ZioGuido/GMLAB_D9X/D9X.jpg

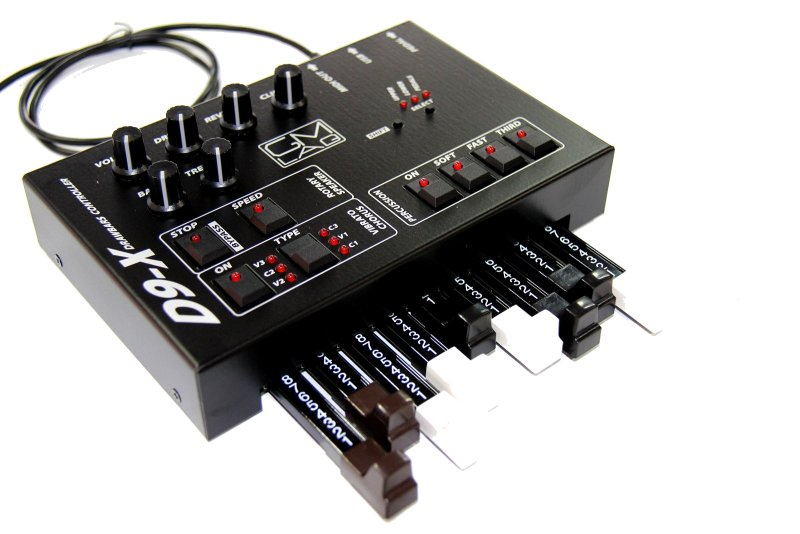
D9X.jpg
