ZioGuido/GMLAB_D9X/README.md

# GMLAB_D9X
Repository for the GMLAB D9X Midi Drawbar Controller

This repository contains the full sources of the GMLAB D9X Midi Drawbar Controller.
Please refer to the included PDF document for details about the project.

Project home page:
http://www.gmlab.it/
