ZioGuido/GMLAB_D9X/PCB/MainBoard.png

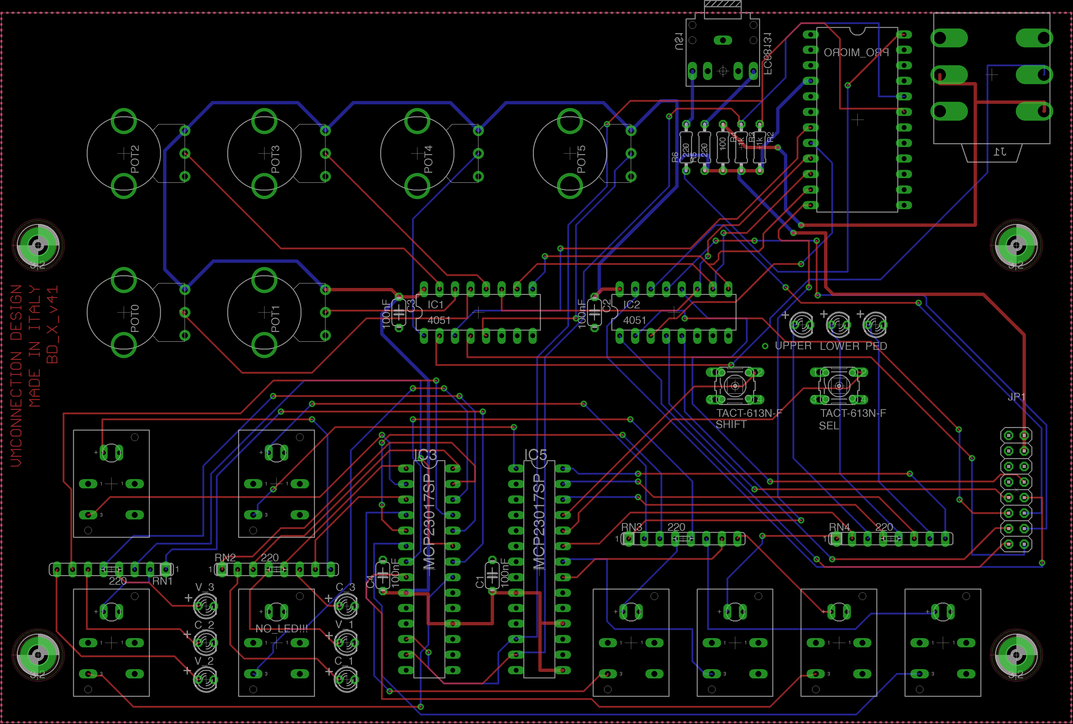
PCB/MainBoard.png
