ZioGuido/GMLAB_D9X/3D/D9X_metal_top.STEP

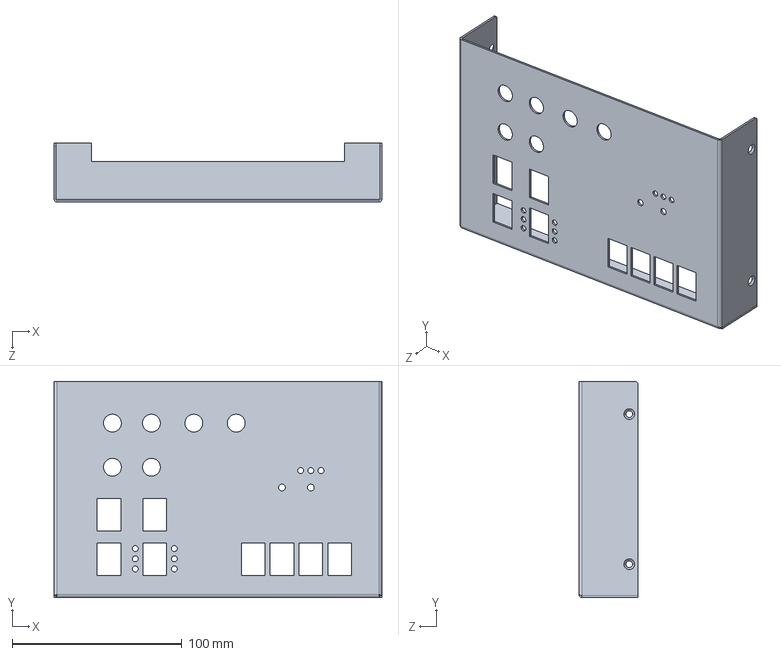
[picture p3: CAD file, 2019-03-20]
3D/D9X_metal_top.STEP
193.4 x 127.5 x 34.9 mm
