ZioGuido/GMLAB_D9X/3D/D9X_metal_base.STEP

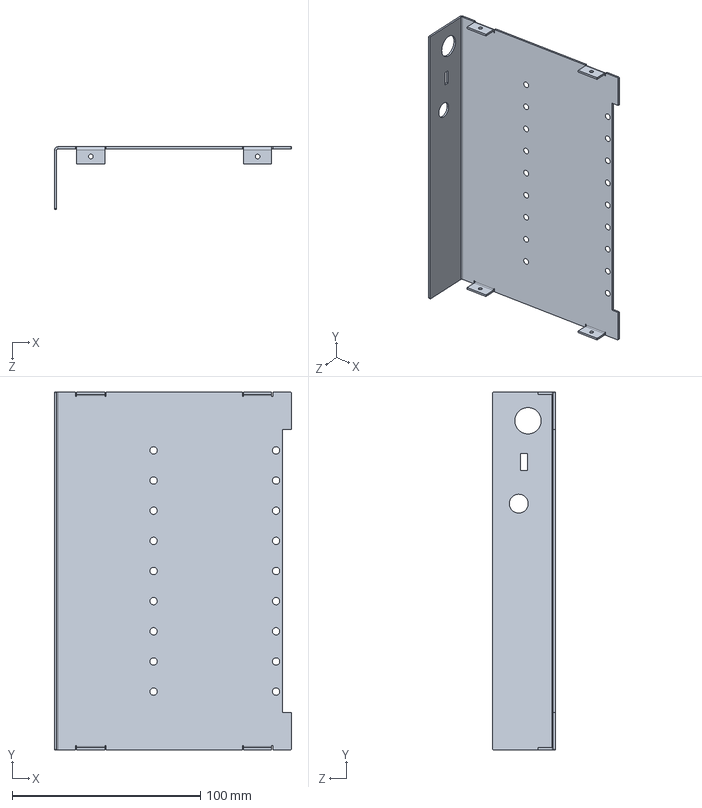
[picture p4: CAD file, 2019-03-20]
3D/D9X_metal_base.STEP
125.8 x 190.0 x 33.2 mm
