ZioGuido/GMLAB_D9X/Silkscreen/D9X.pdf

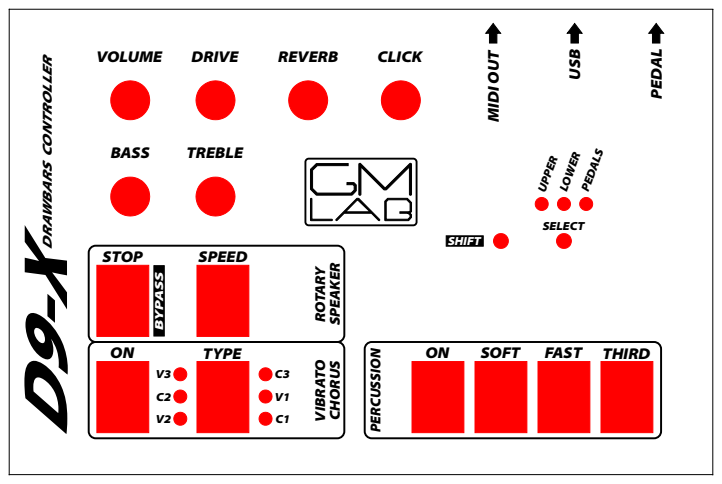
[picture p5: page 1]
SOFT; FAST; THIRD; PERCUSSION; UPPER; LOWER; PEDALS; BASS; TREBLE; VOLUME; DRIVE; REVERB; CLICK; MIDI OUT; USB; PEDAL; D9-XDRAWBARS CONTROLLER; SHIFT; YPASS; SELECT; TYPE; STOP; SPEED; TAR; SPEAKER; VIBR; CHORUS
