ZioGuido/GMLAB_D9X/Eagle/drawbars_v12_2019.brd

## EAGLE design Eagle/drawbars_v12_2019.brd (2019-03-20)

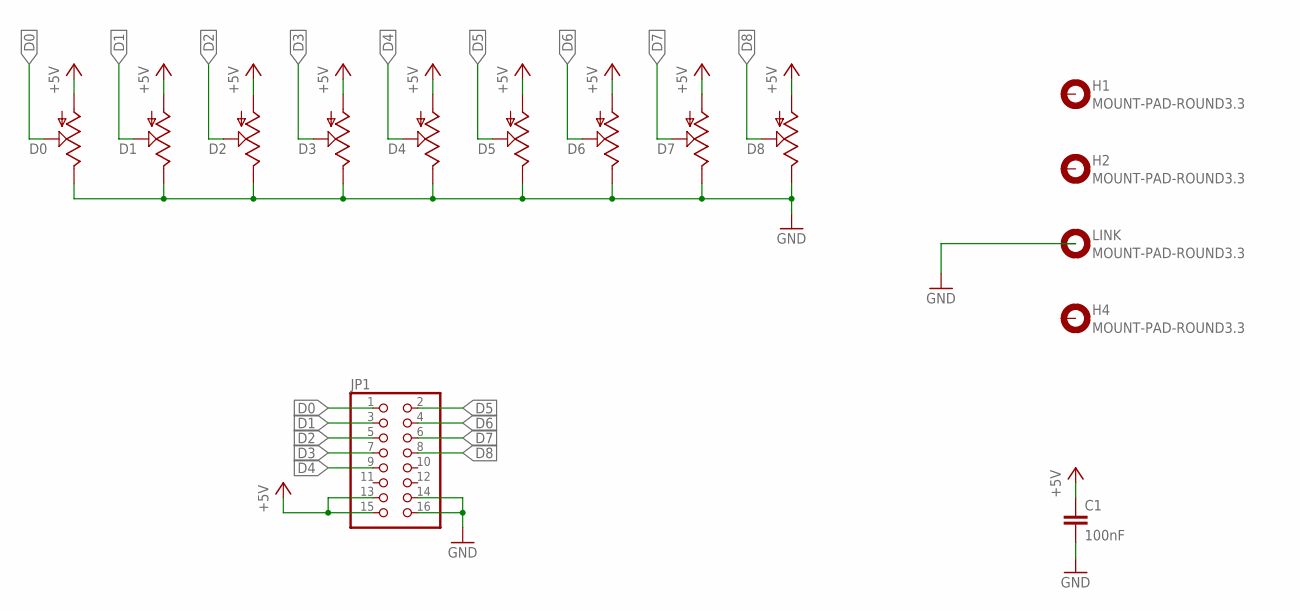
[picture p6: schematic drawbars_v12_2019.sch]

Parts:
C1: 100nF; C050-024X044
D0, D1, D2, D3, D4, D5, D6, D7, D8: POTENTIOMETER; ALPHA_DRAWBARS
H1, H2, H4: MOUNT-PAD-ROUND3.3; 3,3-PAD
JP1: PINHD-2X8; 2X08
LINK: MOUNT-PAD-ROUND3.3; 3,3-PAD

Connections:
+5V: C1.1, D0.P$2 (1), D1.P$2 (1), D2.P$2 (1), D3.P$2 (1), D4.P$2 (1), D5.P$2 (1), D6.P$2 (1), D7.P$2 (1), D8.P$2 (1), JP1.13, JP1.15
D0: D0.P$3 (2), JP1.1
D1: D1.P$3 (2), JP1.3
D2: D2.P$3 (2), JP1.5
D3: D3.P$3 (2), JP1.7
D4: D4.P$3 (2), JP1.9
D5: D5.P$3 (2), JP1.2
D6: D6.P$3 (2), JP1.4
D7: D7.P$3 (2), JP1.6
D8: D8.P$3 (2), JP1.8
GND: C1.2, D0.P$1 (3), D1.P$1 (3), D2.P$1 (3), D3.P$1 (3), D4.P$1 (3), D5.P$1 (3), D6.P$1 (3), D7.P$1 (3), D8.P$1 (3), JP1.14, JP1.16

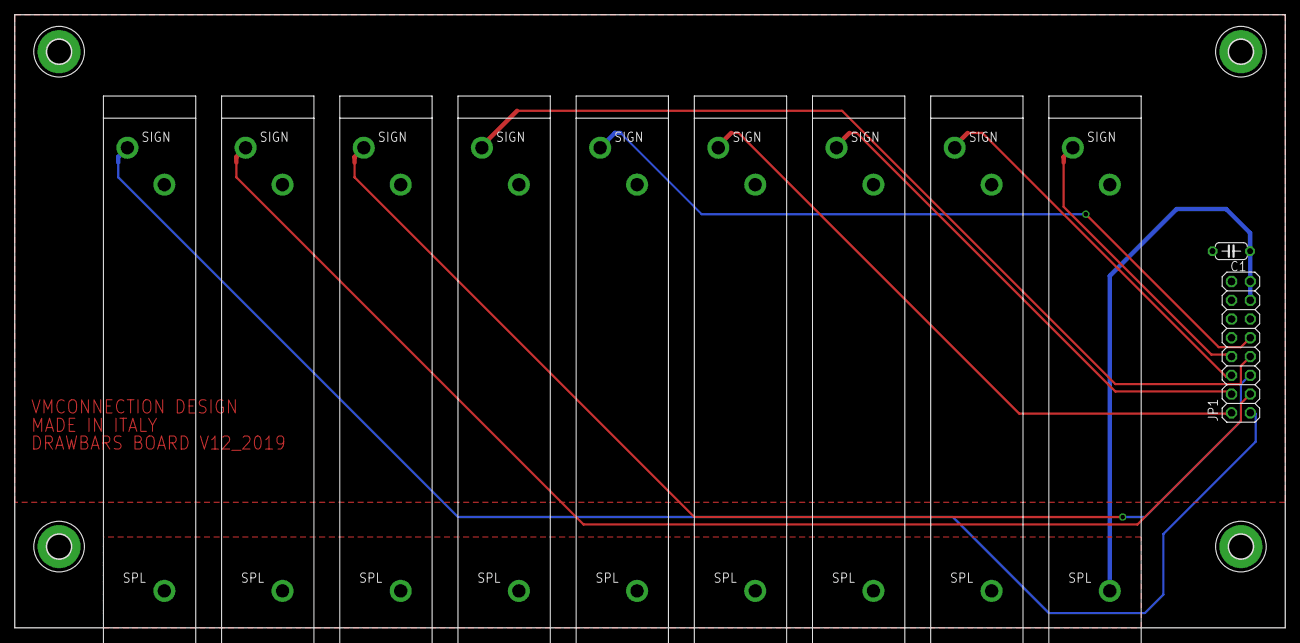
[picture p7: board drawbars_v12_2019.brd from above]

Board: 2 copper layers, 172.0 x 83.0 mm, 15 parts (0 on the bottom side), 11 nets.
