ZioGuido/GMLAB_D9X/Eagle/D9X_v41.brd

## EAGLE design Eagle/D9X_v41.brd (2019-03-20)

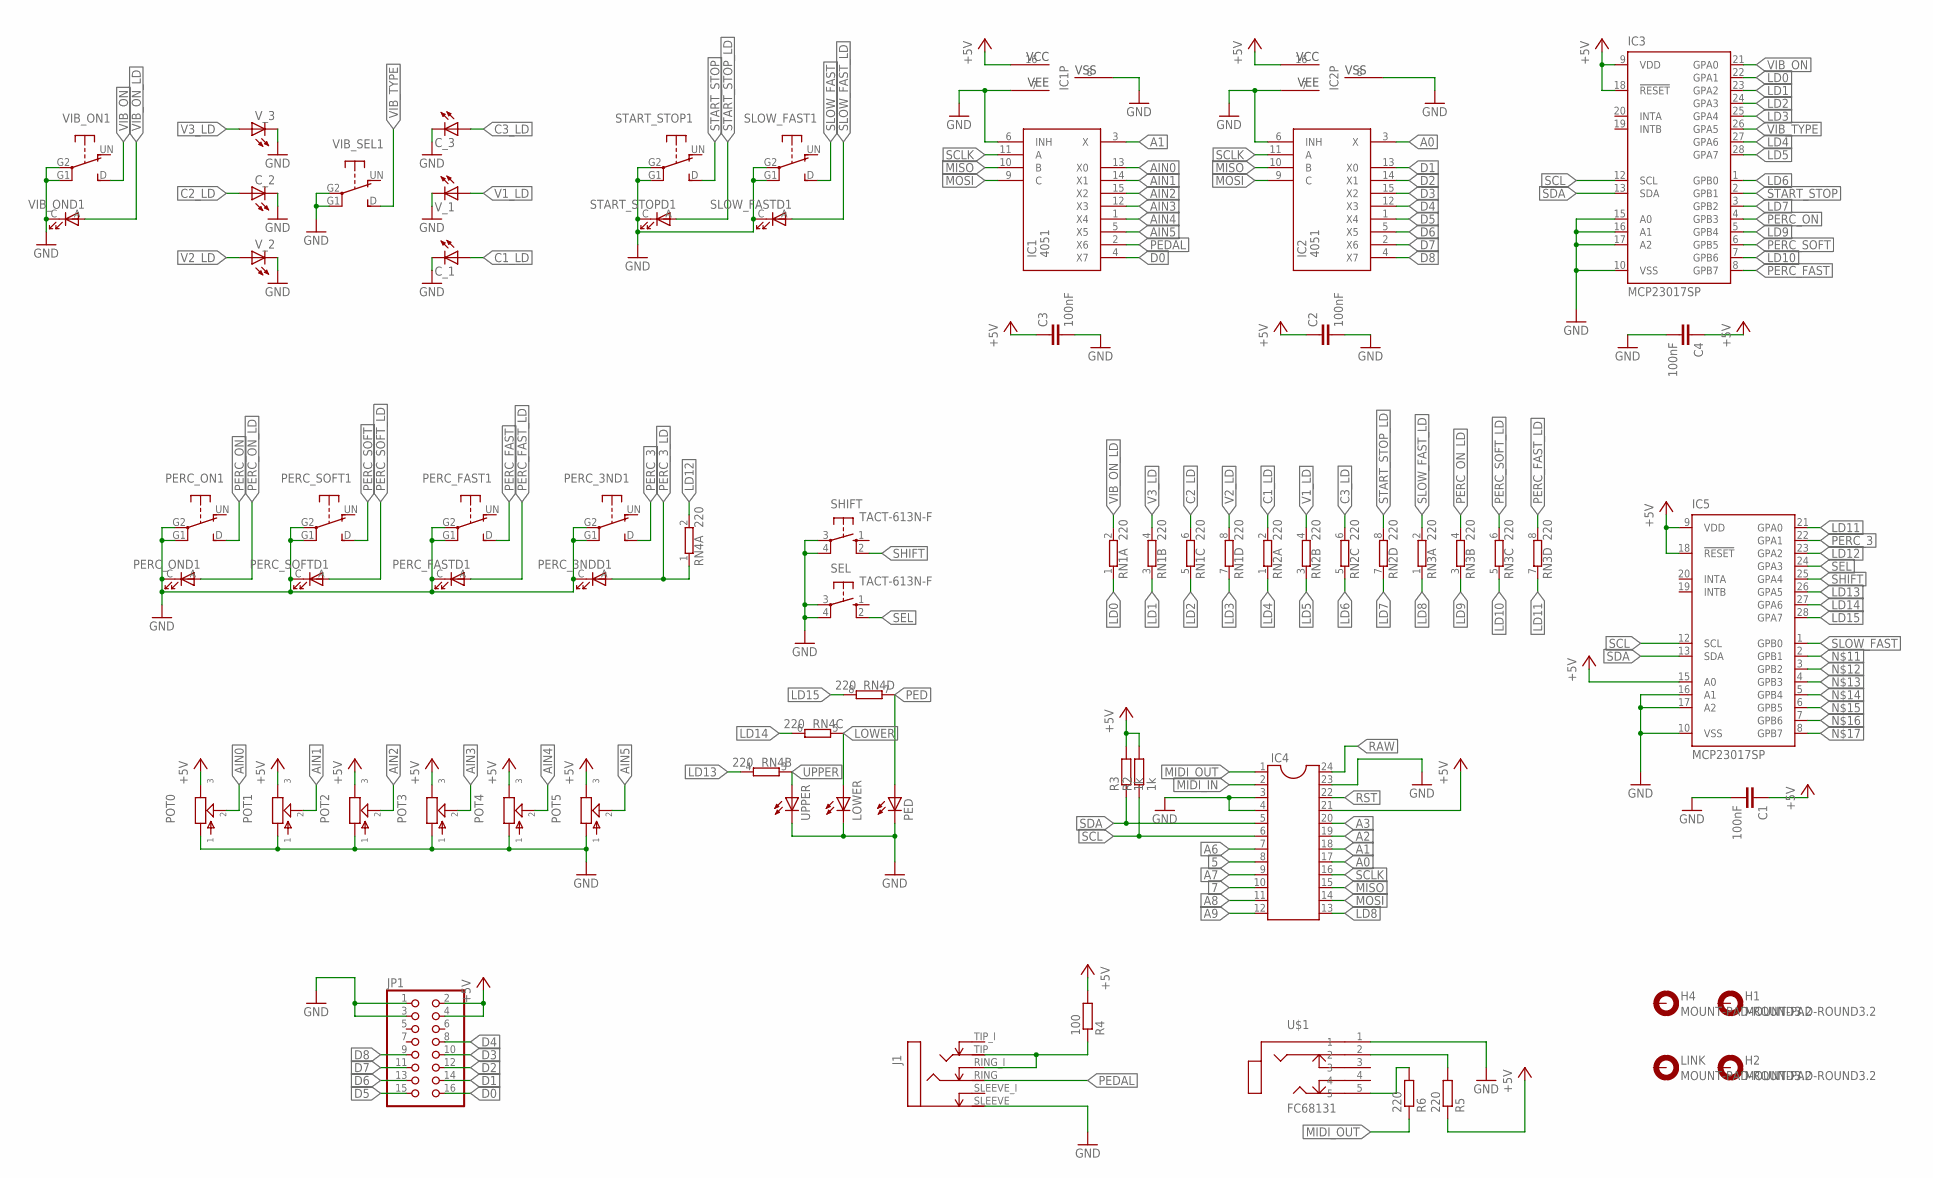
[picture p8: schematic D9X_v41.sch]

Parts:
C1, C2, C3, C4: 100nF; C050-024X044
C_1, C_2, C_3: LED3MM
H1, H2, H4: MOUNT-PAD-ROUND3.2; 3,2-PAD
IC1, IC2: 4051; DIL16
IC3, IC5: MCP23017SP; DIL28-3
IC4: DIL24-6
J1: STEREOSWJACK_ST_TRS_INT; ST_JACK_TRS_INT
JP1: PINHD-2X8; 2X08
LINK: MOUNT-PAD-ROUND3.2; 3,2-PAD
LOWER: LED3MM
PED: LED3MM
PERC_3ND: SRKLSHANPU; SP86N-A1-5-01
PERC_FAST: SRKLSHANPU; SP86N-A1-5-01
PERC_ON: SRKLSHANPU; SP86N-A1-5-01
PERC_SOFT: SRKLSHANPU; SP86N-A1-5-01
POT0, POT1, POT2, POT3, POT4, POT5: POT-EU12MM; RV120DF-40B1-(L)K
R2, R3: 1k; 0204/7
R4: 100; 0204/7
R5, R6: 220; 0204/7
RN1, RN2, RN3, RN4: 220; SIL8
SEL: TACT-613N-F; B3F-10XX
SHIFT: TACT-613N-F; B3F-10XX
SLOW_FAST: SRKLSHANPU; SP86N-A1-5-01
START_STOP: SRKLSHANPU; SP86N-A1-5-01
U$1: FC68131; FC68131-5P
UPPER: LED3MM
VIB_ON: SRKLSHANPU; SP86N-A1-5-01
VIB_SEL: SRKLSHANPU; SP86N-A1-5-01
V_1, V_2, V_3: LED3MM

Connections:
5: IC4.8
7: IC4.10
+5V: C1.1, C2.1, C3.1, C4.1, IC1.16 (VCC), IC2.16 (VCC), IC3.9 (VDD), IC3.18 (!RESET), IC4.21, IC5.9 (VDD), IC5.15 (A0), IC5.18 (!RESET), JP1.2, JP1.4, POT0.3, POT1.3, POT2.3, POT3.3, POT4.3, POT5.3, R2.2, R3.2, R4.2, R5.1
A0: IC2.3 (X), IC4.17
A1: IC1.3 (X), IC4.18
A2: IC4.19
A3: IC4.20
A6: IC4.7
A7: IC4.9
A8: IC4.11
A9: IC4.12
AIN0: IC1.13 (X0), POT0.2
AIN1: IC1.14 (X1), POT1.2
AIN2: IC1.15 (X2), POT2.2
AIN3: IC1.12 (X3), POT3.2
AIN4: IC1.1 (X4), POT4.2
AIN5: IC1.5 (X5), POT5.2
C1_LD: C_1.A, RN2.2
C2_LD: C_2.A, RN1.6 (2)
C3_LD: C_3.A, RN2.6 (2)
D0: IC1.4 (X7), JP1.16
D1: IC2.13 (X0), JP1.14
D2: IC2.14 (X1), JP1.12
D3: IC2.15 (X2), JP1.10
D4: IC2.12 (X3), JP1.8
D5: IC2.1 (X4), JP1.15
D6: IC2.5 (X5), JP1.13
D7: IC2.2 (X6), JP1.11
D8: IC2.4 (X7), JP1.9
GND: C1.2, C2.2, C3.2, C4.2, C_1.K (C), C_2.K (C), C_3.K (C), IC1.6 (INH), IC1.7 (VEE), IC1.8 (VSS), IC2.6 (INH), IC2.7 (VEE), IC2.8 (VSS), IC3.10 (VSS), IC3.15 (A0), IC3.16 (A1), IC3.17 (A2), IC4.3, IC4.4, IC4.23, IC5.10 (VSS), IC5.16 (A1), IC5.17 (A2), J1.SLEEVE (S), JP1.1, JP1.3, LOWER.K (C), PED.K (C), PERC_3ND.C, PERC_3ND.G1, PERC_3ND.G2, PERC_FAST.C, PERC_FAST.G1, PERC_FAST.G2, PERC_ON.C, PERC_ON.G1, PERC_ON.G2, PERC_SOFT.C, PERC_SOFT.G1, PERC_SOFT.G2, POT0.1, POT1.1, POT2.1, POT3.1, POT4.1, POT5.1, SEL.3, SEL.4 (P1), SHIFT.3, SHIFT.4 (P1), SLOW_FAST.C, SLOW_FAST.G1, SLOW_FAST.G2, START_STOP.C, START_STOP.G1, START_STOP.G2, U$1.1, UPPER.K (C), VIB_ON.C, VIB_ON.G1, VIB_ON.G2, VIB_SEL.G1, VIB_SEL.G2, V_1.K (C), V_2.K (C), V_3.K (C)
LD0: IC3.22 (GPA1), RN1.1
LD1: IC3.23 (GPA2), RN1.3 (1)
LD2: IC3.24 (GPA3), RN1.5 (1)
LD3: IC3.25 (GPA4), RN1.7 (1)
LD4: IC3.27 (GPA6), RN2.1
LD5: IC3.28 (GPA7), RN2.3 (1)
LD6: IC3.1 (GPB0), RN2.5 (1)
LD7: IC3.3 (GPB2), RN2.7 (1)
LD8: IC4.13, RN3.1
LD9: IC3.5 (GPB4), RN3.3 (1)
LD10: IC3.7 (GPB6), RN3.5 (1)
LD11: IC5.21 (GPA0), RN3.7 (1)
LD12: IC5.23 (GPA2), RN4.2
LD13: IC5.26 (GPA5), RN4.4 (2)
LD14: IC5.27 (GPA6), RN4.6 (2)
LD15: IC5.28 (GPA7), RN4.8 (2)
LOWER: LOWER.A, RN4.5 (1)
MIDI_IN: IC4.2
MIDI_OUT: IC4.1, R6.1
MISO: IC1.10 (B), IC2.10 (B), IC4.15
MOSI: IC1.9 (C), IC2.9 (C), IC4.14
unnamed: J1.RING_I (RN), J1.TIP (T), R4.1
unnamed: R5.2, U$1.2
unnamed: R6.2, U$1.5
PED: PED.A, RN4.7 (1)
PEDAL: IC1.2 (X6), J1.RING (R)
PERC_3: IC5.22 (GPA1), PERC_3ND.D (S)
PERC_3_LD: PERC_3ND.A, RN4.1
PERC_FAST: IC3.8 (GPB7), PERC_FAST.D (S)
PERC_FAST_LD: PERC_FAST.A, RN3.8 (2)
PERC_ON: IC3.4 (GPB3), PERC_ON.D (S)
PERC_ON_LD: PERC_ON.A, RN3.4 (2)
PERC_SOFT: IC3.6 (GPB5), PERC_SOFT.D (S)
PERC_SOFT_LD: PERC_SOFT.A, RN3.6 (2)
RAW: IC4.24
RST: IC4.22
SCL: IC3.12 (SCL), IC4.6, IC5.12 (SCL), R2.1
SCLK: IC1.11 (A), IC2.11 (A), IC4.16
SDA: IC3.13 (SDA), IC4.5, IC5.13 (SDA), R3.1
SEL: IC5.24 (GPA3), SEL.2 (S1)
SHIFT: IC5.25 (GPA4), SHIFT.2 (S1)
SLOW_FAST: IC5.1 (GPB0), SLOW_FAST.D (S)
SLOW_FAST_LD: RN3.2, SLOW_FAST.A
START_STOP: IC3.2 (GPB1), START_STOP.D (S)
START_STOP_LD: RN2.8 (2), START_STOP.A
UPPER: RN4.3 (1), UPPER.A
V1_LD: RN2.4 (2), V_1.A
V2_LD: RN1.8 (2), V_2.A
V3_LD: RN1.4 (2), V_3.A
VIB_ON: IC3.21 (GPA0), VIB_ON.D (S)
VIB_ON_LD: RN1.2, VIB_ON.A
VIB_TYPE: IC3.26 (GPA5), VIB_SEL.D (S)

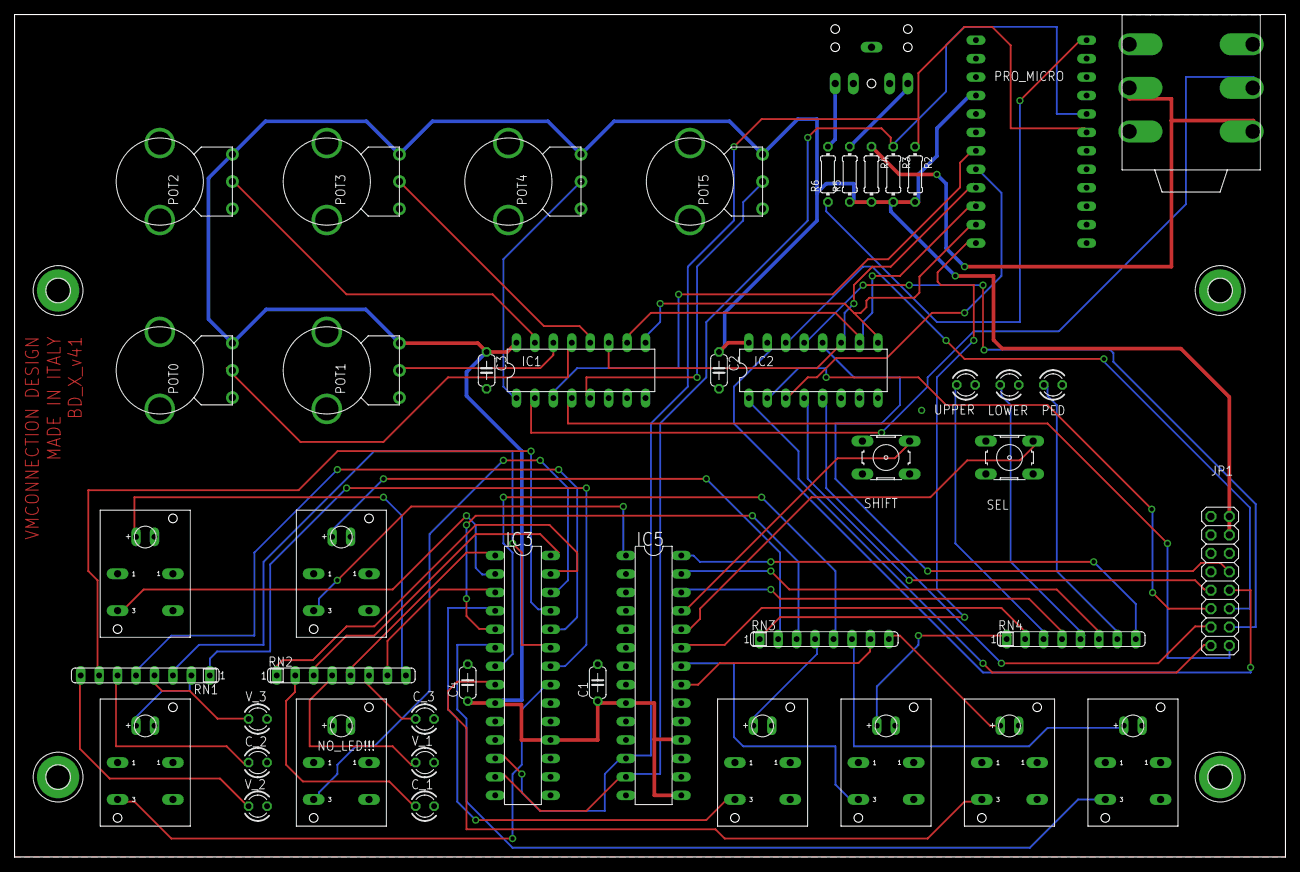
[picture p9: board D9X_v41.brd from above]

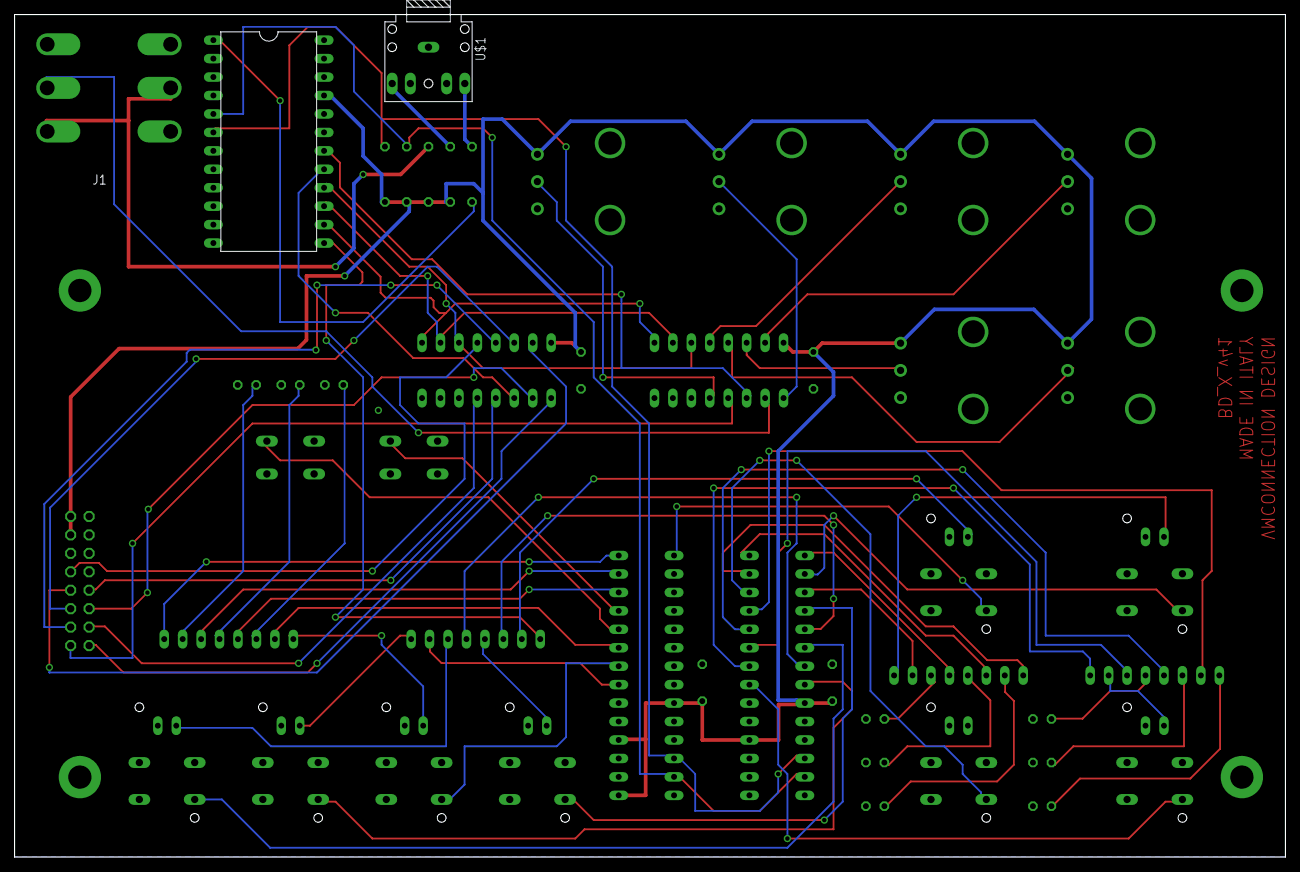
[picture p10: board D9X_v41.brd from below]

Board: 2 copper layers, 175.0 x 116.0 mm, 50 parts (3 on the bottom side), 71 nets.
