ZioGuido/GMLAB_D9X/(notices)

Notices in the files:
parts and their libraries:
atari: Copyright (c) 2010
Copyright (c) 2009
This library is licensed under the
Creative Commons Attribution 3.0 United States License.
